IngramSwift/Buck-Controler-based-on-STM32/样品.jpg

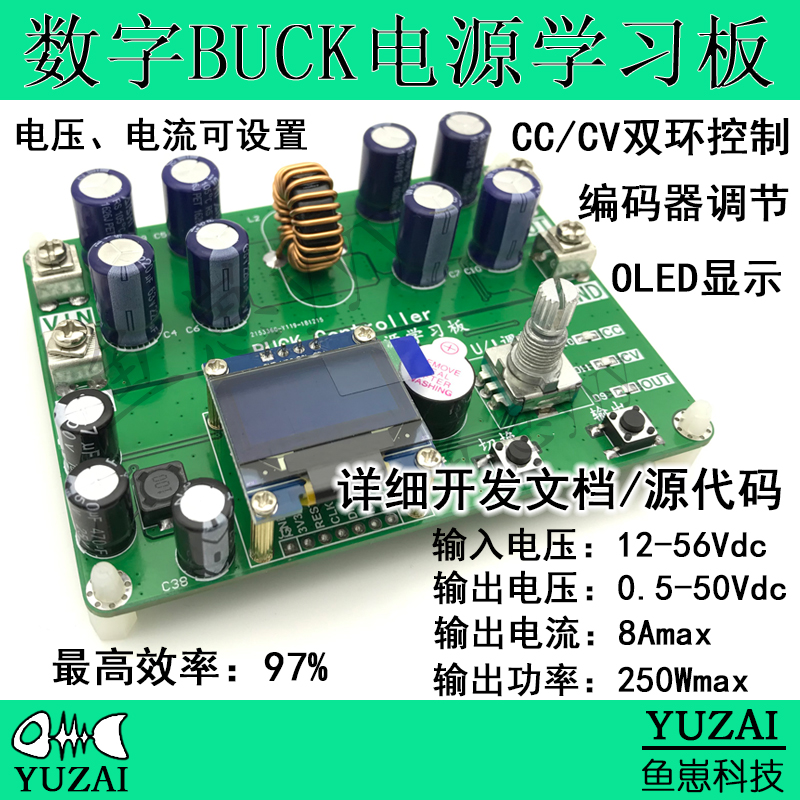
样品.jpg
