IngramSwift/Buck-Controler-based-on-STM32/同步整流BUCK资料_V1.2/程序代码/Buck_M0+_V1.1_VSCode/校准说明.JPG

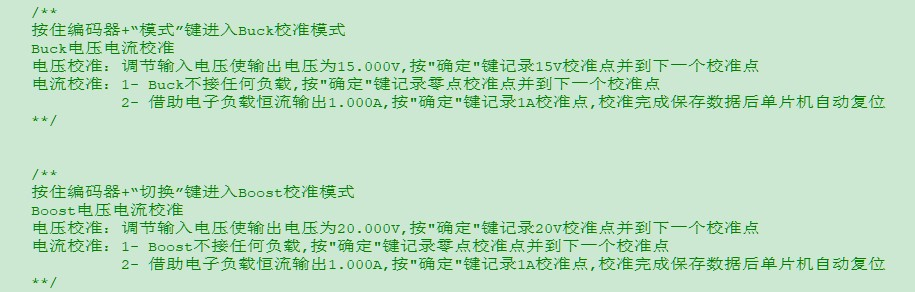
同步整流BUCK资料_V1.2/程序代码/Buck_M0+_V1.1_VSCode/校准说明.JPG
