IngramSwift/Buck-Controler-based-on-STM32/同步整流BUCK资料_V1.2/程序代码/Buck_M0+_V1.1/说明.txt

====================================================
181108-
	1）加入电压电流校准 （已完成）
====================================================
