IngramSwift/Buck-Controler-based-on-STM32/2_电路原理图/数字电源控制器_元件清单.xlsx

序号 | 名称 | 位号 | 规格 | 数量 | 引脚
1 | LED | LED1,LED2,LED3 | 0805 | 3 | 2
2 | 33pf | C5,C6 | 0805 | 2 | 2
3 | 104 | C1,C2,C3,C4,C7,C8,C9,C10,C11,C12,C13,C14,C19,C21,C22,C23,C24 | 0805 | 17 | 2
4 | 103 | C18,C20 | 0805 | 2 | 2
5 | 100R | R4 ,R21,R22 | 0805 | 3 | 2
6 | 103 | R1,R6,R2,R3,R5 | 0805 | 5 | 2
7 | 102 | R12,R13,R16,R18,R19 | 0805 | 5 | 2
8 | 512 | R8,R15 | 0805 | 2 | 2
9 | 303 | R9 | 0805 | 1 | 2
10 | 472 | R10 | 0805 | 1 | 2
11 | 913 | R11,R14 | 0805 | 2 | 2
12 | 363 | R17 | 0805 | 1 | 2
13 | 采样电阻r010_5W | R20 |  | 1 | 2
14 | 电解电容_100uF/63v | C15 |  | 1 | 2 | 3.5元/20个
15 | 电解电容_470uF/35v | C16,C17 |  | 2 | 2 | 4.8元/20个
16 | 电解电容_220uF/63v | C25,C26,C27,C28,C29,C30,C31,C32 |  | 8 | 2 | 2.9元/10个
17 | 电感_33uH | U8 |  | 1 | 2 | 优信电子(2.3元/个)
18 | 电感_100uH | U6 |  | 1 | 2 | 优信电子(0.37元/个)
19 | ss310 | D1,D2 |  | 2 | 2 | 优信电子(2元/5个)
20 | 4148_二极管 | D3,D4 |  | 2 | 2 |  |  | 3元/50个
21 | BELL(1.0)CM | U3 |  | 1 | 2 | 0.49元/个
22 | 晶振_8MHz | X1 |  | 1 | 2 | 优信电子(2.8元/10个)
23 | 三极管_SS8050 | U2 |  | 1 | 3 | 优信电子(1.4元/20个)
24 | MOSFET_HY1908D | Q1,Q2 |  | 2 | 3 |  | 1.3元/个
25 | 0.96OLED_4P | OLED1 |  | 1 | 4 | 优信电子(13元/个)
26 | EC11E15 | SW3 |  | 1 | 7 | 优信电子(1.5元/个)
27 | XL7005ADJ | U4 |  | 1 | 9 | 优信电子(0.91元/个)
28 | AMS1117-3.3V | U5 |  | 1 | 4 | 优信电子(0.4元/个)
29 | EG3013 | U7 |  | 1 | 8 |  | 0.52元/个
30 | LMC6482AIM | U9 |  | 1 | 8 | 优信电子(4.85元/块)
31 | STM32F030K6T6 | U1 |  | 1 | 32 | 优信电子(2.9元/块)
