IngramSwift/Buck-Controler-based-on-STM32/2_电路原理图/元件清单.xlsx

序号 | 型号 | 位号 | 封装 | 数量 | 引脚
电容
1 | 33pf | C5,C6 | 0805 | 20 | 2
2 | 104 | C1,C2,C3,C4,C7,C8,C9,C10,C11,C12,C13,C14,C19,C21,C22,C23,C24 | 0805 | 30 | 2
3 | 103 | C18,C20 | 0805 | 20 | 2
电阻
4 | 101 | R4,R21,R22 | 0805 | 20 | 2
5 | 102 | R12,R13,R16,R18,R19 | 0805 | 20 | 2
6 | 103 | R1,R6,R2,R3,R5 | 0805 | 20 | 2
7 | 512 | R8,R15 | 0805 | 20 | 2
8 | 303 | R9 | 0805 | 20 | 2
9 | 472 | R10 | 0805 | 20 | 2
10 | 913 | R11,R14 | 0805 | 20 | 2
11 | 363 | R17 | 0805 | 20 | 2
