IngramSwift/Buck-Controler-based-on-STM32/2_电路原理图/同步整流BUCK-SCH.pdf

# BUCK主拓扑

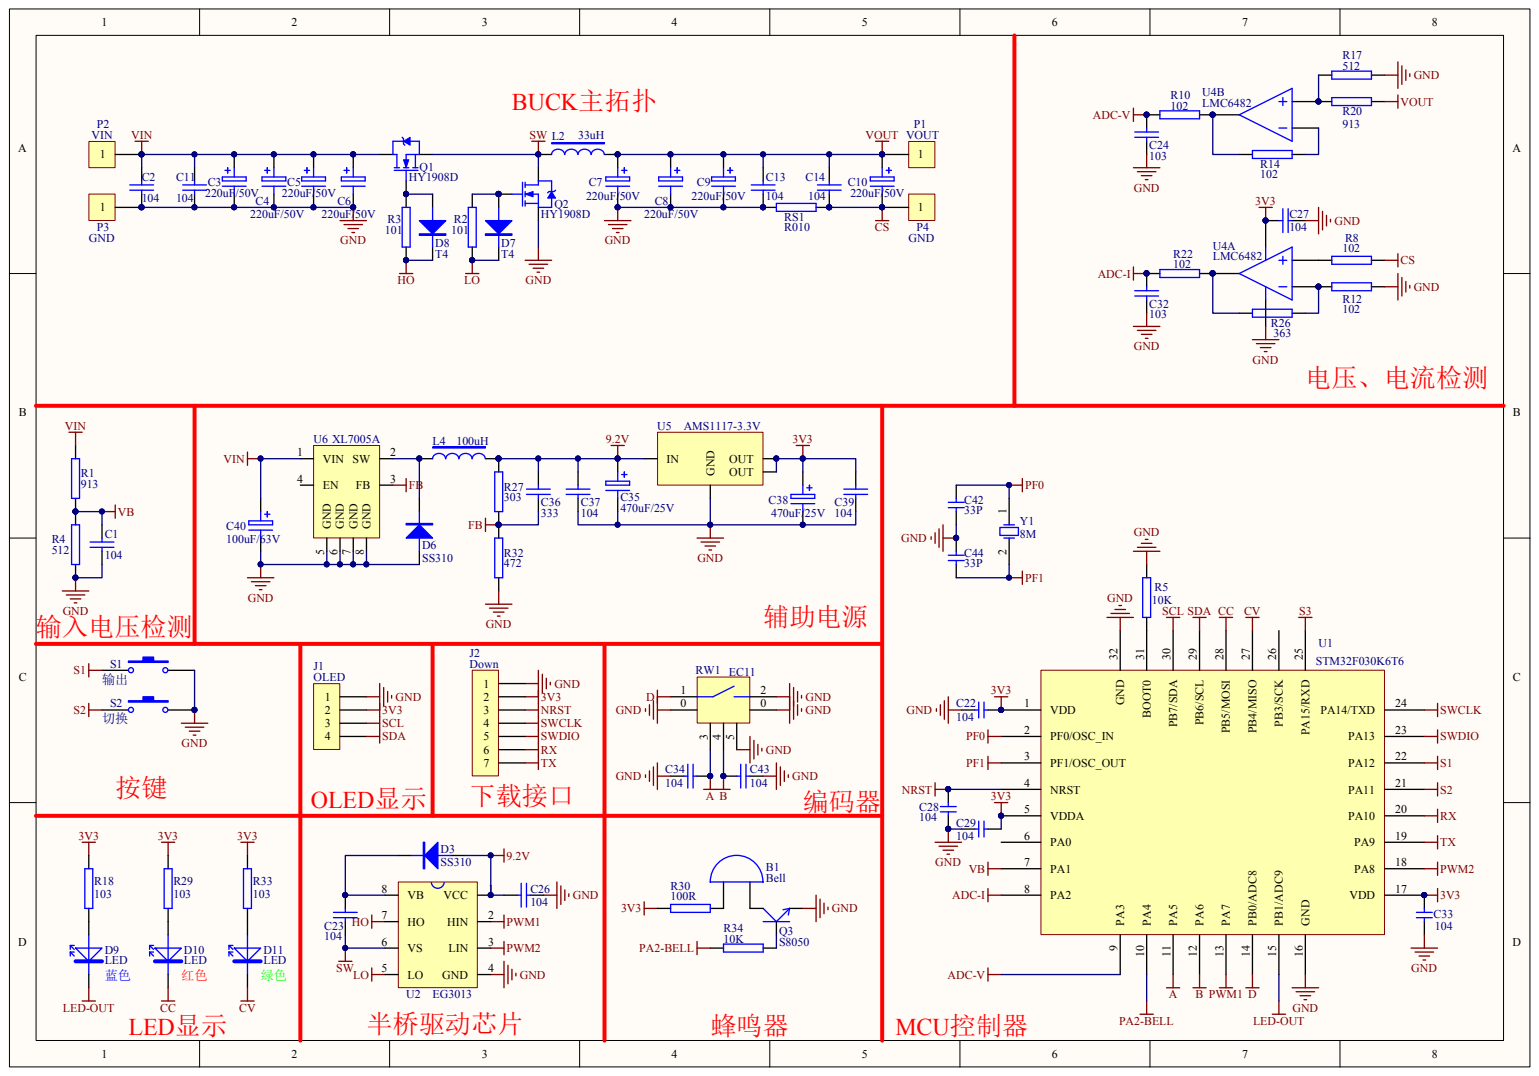
[picture p13: page 1]
