IngramSwift/Buck-Controler-based-on-STM32/同步整流BUCK资料_V1.2/参考资料/Buck变换器的闭环回路设计之PID调节教程.pdf

# Buck 变换器的闭环回路设计之 PID 调节

## 1.确定电容电感大小

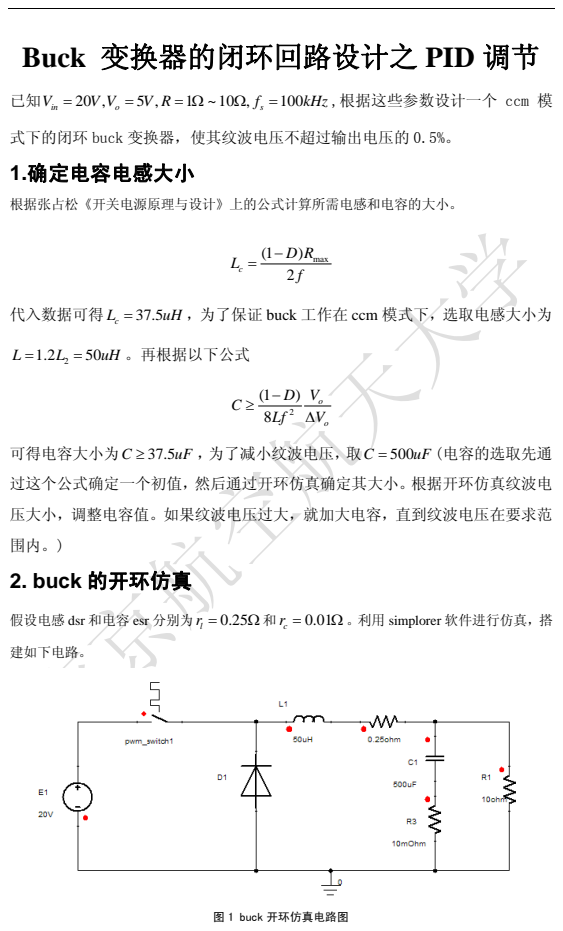
[picture p14: page 1]
kHz in; ,根据这些参数设计一个 ccm 模; max (1; 代入数据可得; ，为了保证 buck 工作在 ccm 模式下，选取电感大小为; 。再根据以下公式; 可得电容大小为C; ，为了减小纹波电压，取C; (电容的选取先通; 围内。) 2. buck 的开环仿真; 假设电感 dsr 和电容 esr 分别为; W 。利用 simplorer 软件进行仿真，搭; 建如下电路。; 图 1 buck 开环仿真电路图

式下的闭环 buck 变换器，使其纹波电压不超过输出电压的 0.5%。

根据张占松《开关电源原理与设计》上的公式计算所需电感和电容的大小。

过这个公式确定一个初值，然后通过开环仿真确定其大小。根据开环仿真纹波电

压大小，调整电容值。如果纹波电压过大，就加大电容，直到纹波电压在要求范

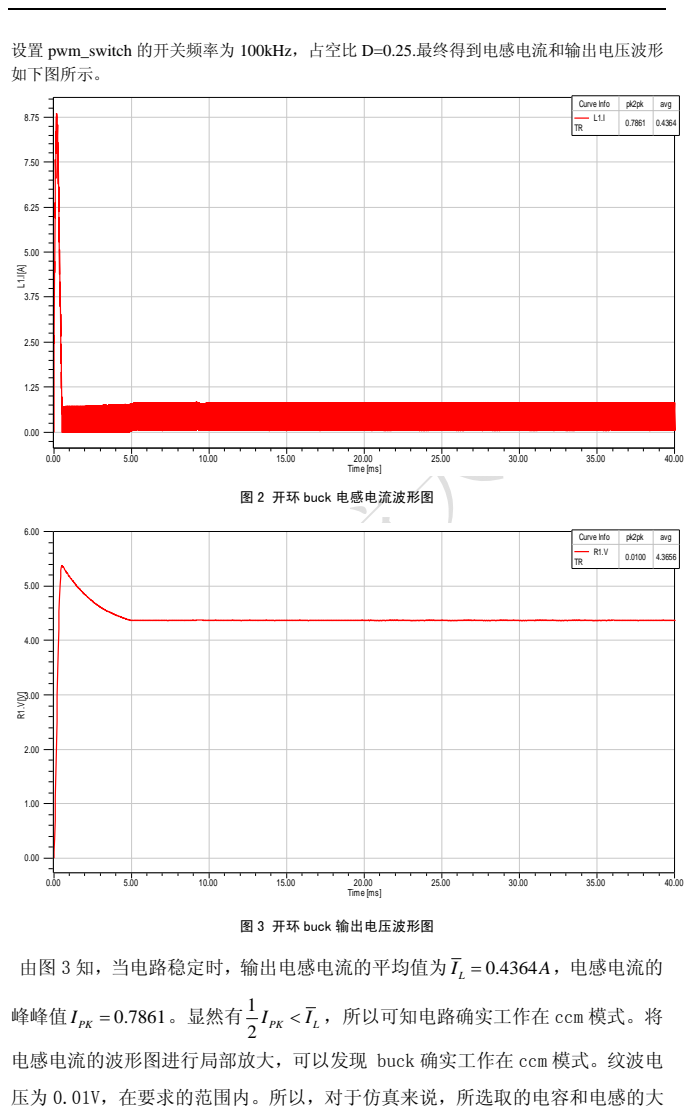
[picture p15: page 2]
Time [ms]; 40.00 Time [ms]; 由图 3 知，当电路稳定时，输出电感电流的平均值为; ，电感电流的; 峰峰值; 。显然有 1; I < ，所以可知电路确实工作在 ccm 模式。将

设置 pwm_switch 的开关频率为 100kHz，占空比 D=0.25.最终得到电感电流和输出电压波形
如下图所示。

Curve Info | | pk2pk | avg
TR | L1.I | 0.7861 | 0.4364

图 2 开环 buck 电感电流波形图

TR | R1.V | 0.0100 | 4.3656

图 3 开环 buck 输出电压波形图

电感电流的波形图进行局部放大，可以发现 buck 确实工作在 ccm 模式。纹波电

压为 0.01V，在要求的范围内。所以，对于仿真来说，所选取的电容和电感的大

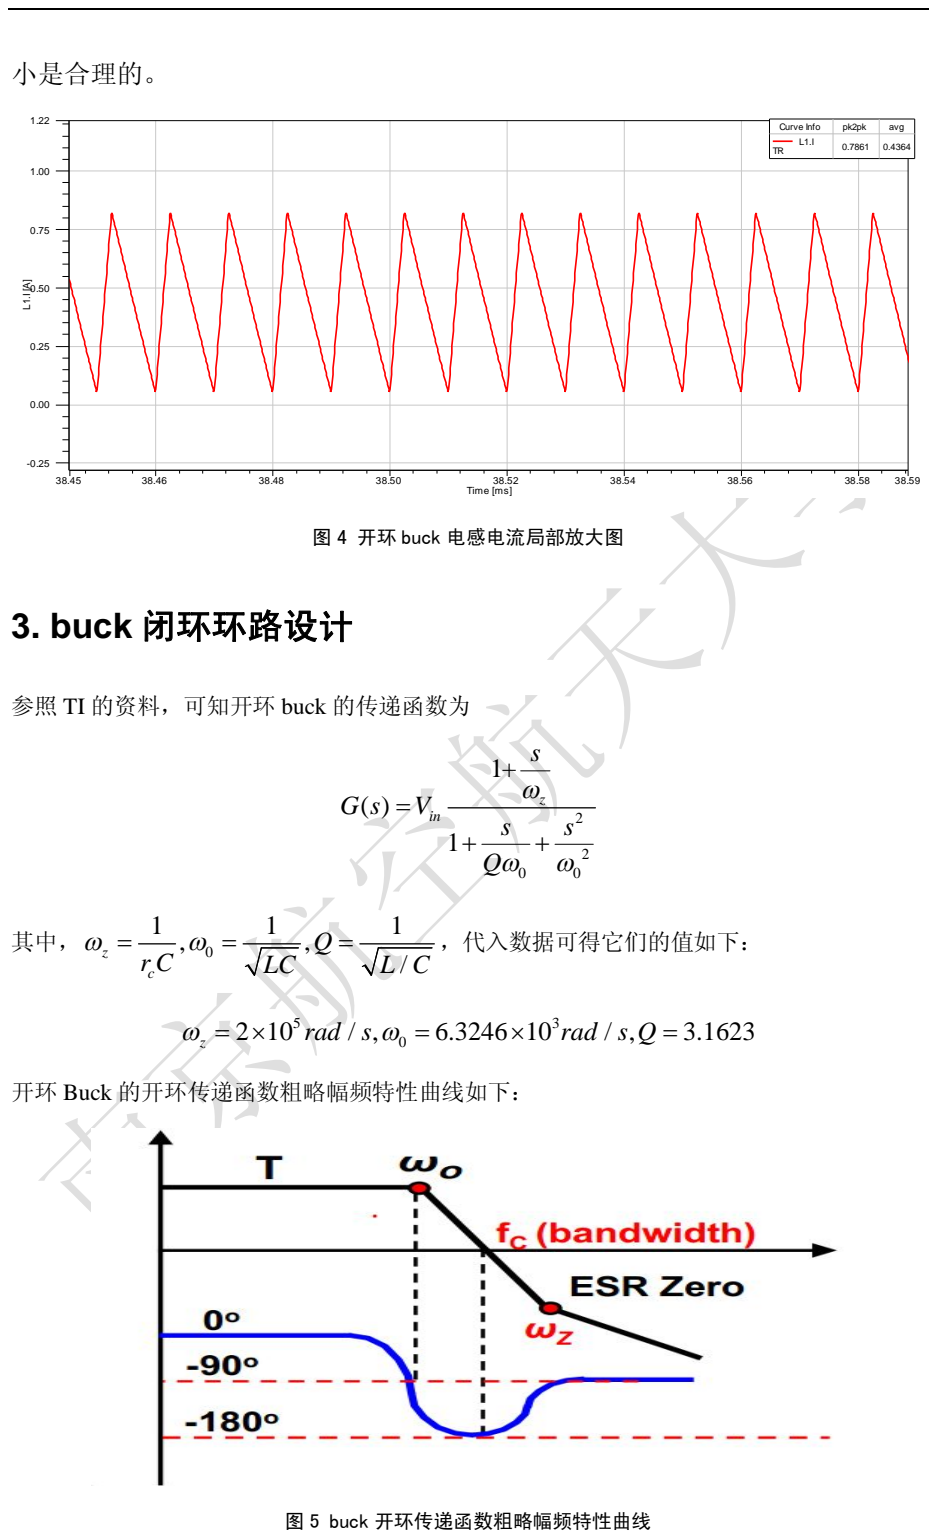
[picture p16: page 3]
小是合理的。; Time [ms]; 3. buck 闭环环路设计; ，代入数据可得它们的值如下：; = rad s; rad s Q; 图 5 buck 开环传递函数粗略幅频特性曲线

Curve Info | pk2pk | avg
L1.I TR | 0.7861 | 0.4364

图 4 开环 buck 电感电流局部放大图

参照 TI 的资料，可知开环 buck 的传递函数为

开环 Buck 的开环传递函数粗略幅频特性曲线如下：

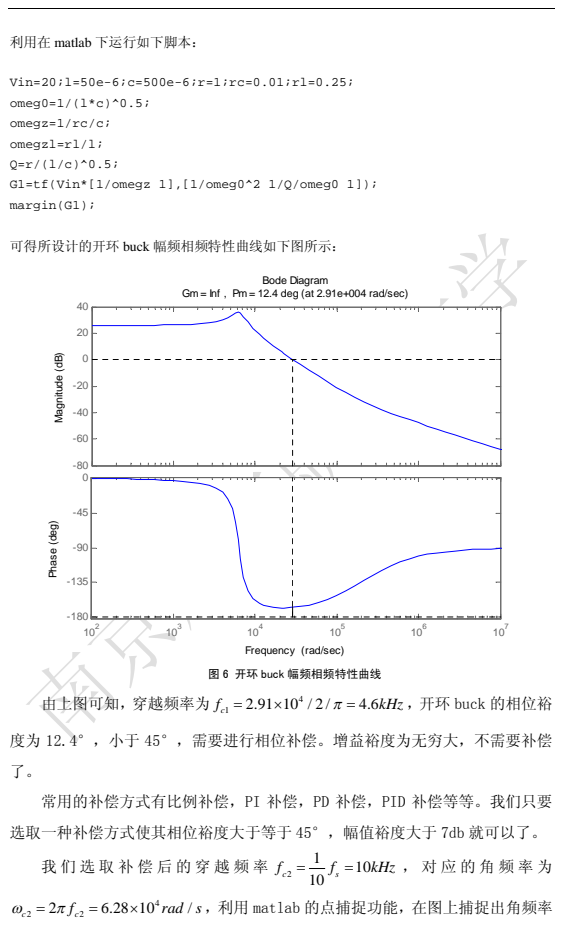
[picture p17: page 4]
Magnitude (dB); Phase (deg); Bode Diagram; 由上图可知，穿越频率为; kHz =; ，开环 buck 的相位裕; rad s ，利用 matlab 的点捕捉功能，在图上捕捉出角频率

利用在 matlab 下运行如下脚本：

Vin=20;l=50e-6;c=500e-6;r=1;rc=0.01;rl=0.25;
omeg0=1/(l*c)^0.5;
omegz=1/rc/c;
omegzl=rl/l;
G1=tf(Vin*[1/omegz 1],[1/omeg0^2 1/Q/omeg0 1]);
margin(G1);

可得所设计的开环 buck 幅频相频特性曲线如下图所示：

Gm = Inf , Pm = 12.4 deg (at 2.91e+004 rad/sec)

Frequency (rad/sec)

图 6 开环 buck 幅频相频特性曲线

度为 12.4°，小于 45°，需要进行相位补偿。增益裕度为无穷大，不需要补偿

常用的补偿方式有比例补偿，PI 补偿，PD 补偿，PID 补偿等等。我们只要

选取一种补偿方式使其相位裕度大于等于 45°，幅值裕度大于 7db 就可以了。

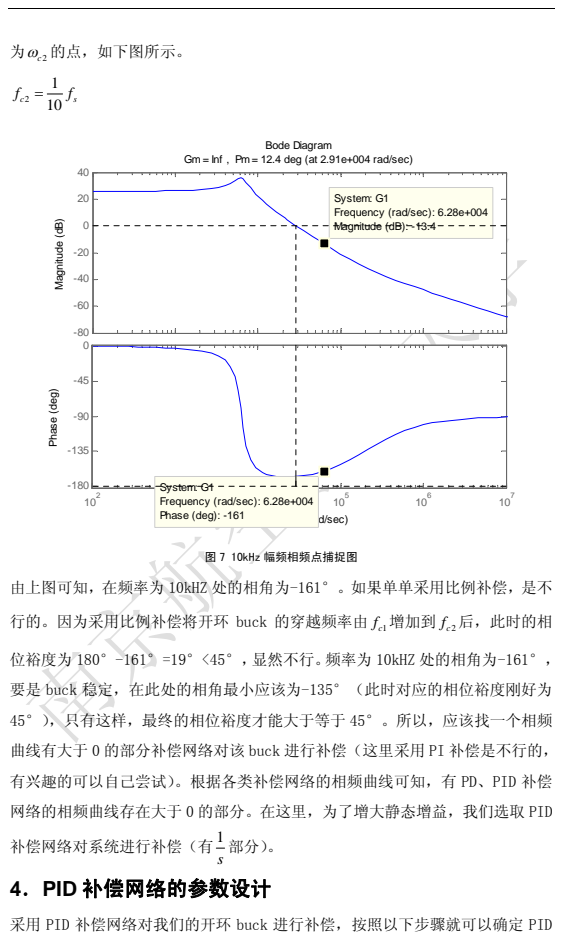
[picture p18: page 5]
为wc2 的点，如下图所示。; Bode Diagram; Phase (deg); Magnitude (dB); 图 7 10kHz 幅频相频点捕捉图; 4．PID 补偿网络的参数设计

Gm = Inf , Pm = 12.4 deg (at 2.91e+004 rad/sec)

System: G1
Frequency (rad/sec): 6.28e+004
Magnitude (dB): -13.4

Phase (deg): -161

Frequency (rad/sec)

由上图可知，在频率为 10kHZ 处的相角为-161°。如果单单采用比例补偿，是不

行的。因为采用比例补偿将开环 buck 的穿越频率由 c1 f 增加到 c2 f 后，此时的相

位裕度为 180°-161°=19°<45°，显然不行。频率为 10kHZ 处的相角为-161°，

要是 buck 稳定，在此处的相角最小应该为-135°（此时对应的相位裕度刚好为

45°），只有这样，最终的相位裕度才能大于等于 45°。所以，应该找一个相频

曲线有大于 0 的部分补偿网络对该 buck 进行补偿（这里采用 PI 补偿是不行的，

有兴趣的可以自己尝试）。根据各类补偿网络的相频曲线可知，有 PD、PID 补偿

网络的相频曲线存在大于 0 的部分。在这里，为了增大静态增益，我们选取 PID
补偿网络对系统进行补偿（有 1

采用 PID 补偿网络对我们的开环 buck 进行补偿，按照以下步骤就可以确定 PID

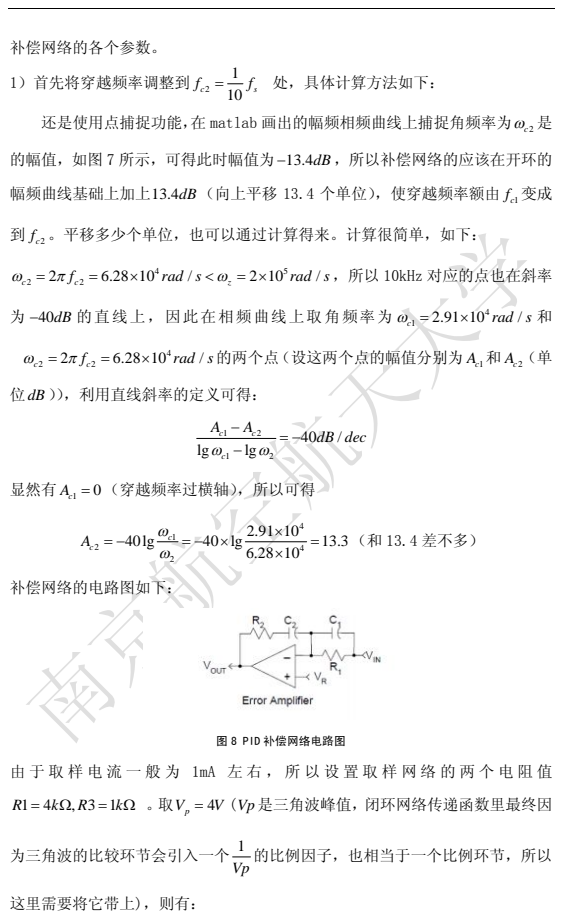
[picture p19: page 6]
补偿网络的各个参数。; 1）首先将穿越频率调整到 2; 处，具体计算方法如下：; 还是使用点捕捉功能，在 matlab 画出的幅频相频曲线上捕捉角频率为wc2 是; rad s; rad s，所以 10kHz 对应的点也在斜率; 为 -40dB 的直线上，因此在相频曲线上取角频率为; rad s 和; rad s 的两个点（设这两个点的幅值分别为 Ac1和 Ac2; 位dB）），利用直线斜率的定义可得：; dB dec; 显然有 1; 0 Ac = （穿越频率过横轴），所以可得; （和 13.4 差不多）; 补偿网络的电路图如下：; 图 8 PID 补偿网络电路图; (Vp是三角波峰值，闭环网络传递函数里最终因; 为三角波的比较环节会引入一个 1; 这里需要将它带上)，则有：

的幅值，如图 7 所示，可得此时幅值为-13.4dB ，所以补偿网络的应该在开环的

幅频曲线基础上加上13.4dB（向上平移 13.4 个单位），使穿越频率额由 c1 f 变成

到 c2 f 。平移多少个单位，也可以通过计算得来。计算很简单，如下：

的比例因子，也相当于一个比例环节，所以

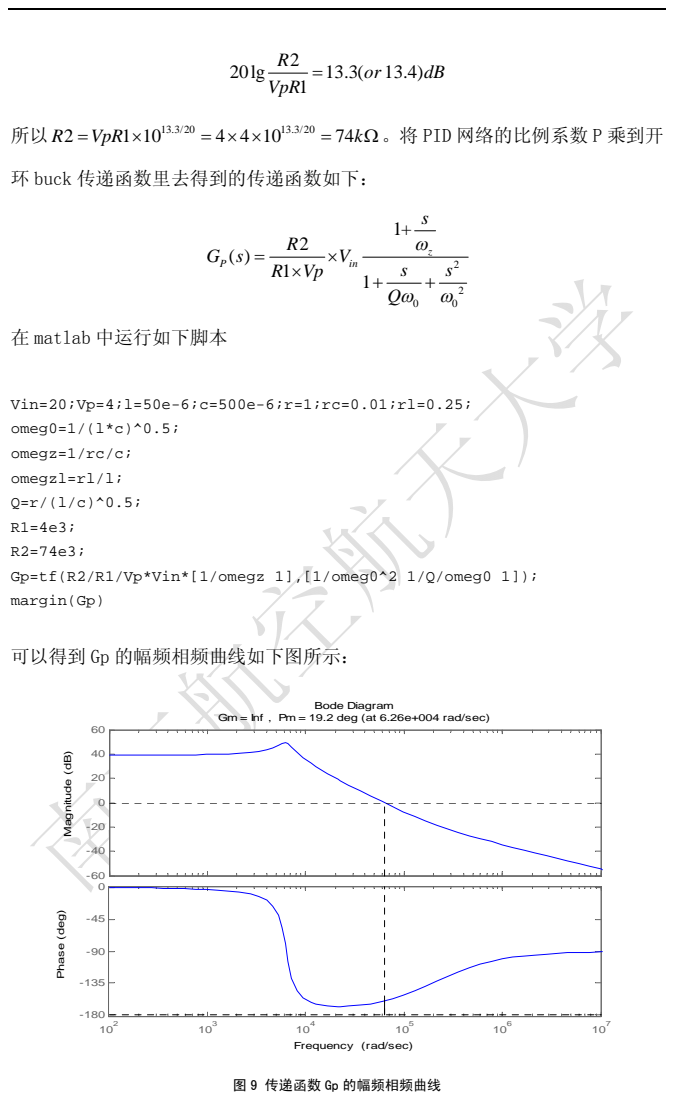
[picture p20: page 7]
VpR =; VpR; W。将 PID 网络的比例系数 P 乘到开; 环 buck 传递函数里去得到的传递函数如下：; 在 matlab 中运行如下脚本; Magnitude (dB); Phase (deg); Bode Diagram

Vin=20;Vp=4;l=50e-6;c=500e-6;r=1;rc=0.01;rl=0.25;
omeg0=1/(l*c)^0.5;
omegz=1/rc/c;
omegzl=rl/l;
Gp=tf(R2/R1/Vp*Vin*[1/omegz 1],[1/omeg0^2 1/Q/omeg0 1]);
margin(Gp)

可以得到 Gp 的幅频相频曲线如下图所示：

Gm = Inf , Pm = 19.2 deg (at 6.26e+004 rad/sec)

Frequency (rad/sec)

图 9 传递函数 Gp 的幅频相频曲线

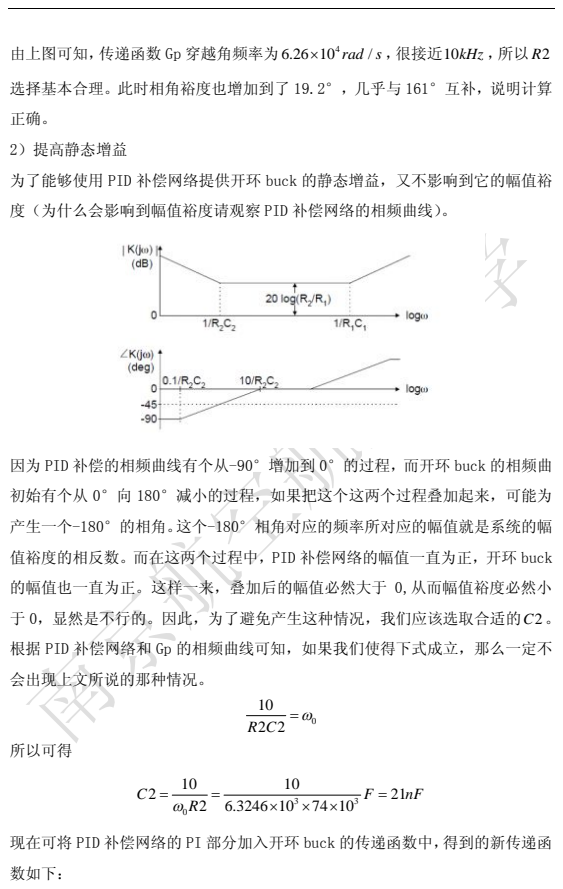
[picture p21: page 8]
由上图可知，传递函数 Gp 穿越角频率为; rad s ，很接近10kHz ，所以 R2; 2）提高静态增益; 会出现上文所说的那种情况。; 所以可得; 数如下：

选择基本合理。此时相角裕度也增加到了 19.2°，几乎与 161°互补，说明计算

为了能够使用 PID 补偿网络提供开环 buck 的静态增益，又不影响到它的幅值裕

度（为什么会影响到幅值裕度请观察 PID 补偿网络的相频曲线）。

因为 PID 补偿的相频曲线有个从-90°增加到 0°的过程，而开环 buck 的相频曲

初始有个从 0°向 180°减小的过程，如果把这个这两个过程叠加起来，可能为

产生一个-180°的相角。这个-180°相角对应的频率所对应的幅值就是系统的幅

值裕度的相反数。而在这两个过程中，PID 补偿网络的幅值一直为正，开环 buck

的幅值也一直为正。这样一来，叠加后的幅值必然大于 0,从而幅值裕度必然小

于 0，显然是不行的。因此，为了避免产生这种情况，我们应该选取合适的C2。

根据 PID 补偿网络和 Gp 的相频曲线可知，如果我们使得下式成立，那么一定不

现在可将 PID 补偿网络的 PI 部分加入开环 buck 的传递函数中，得到的新传递函

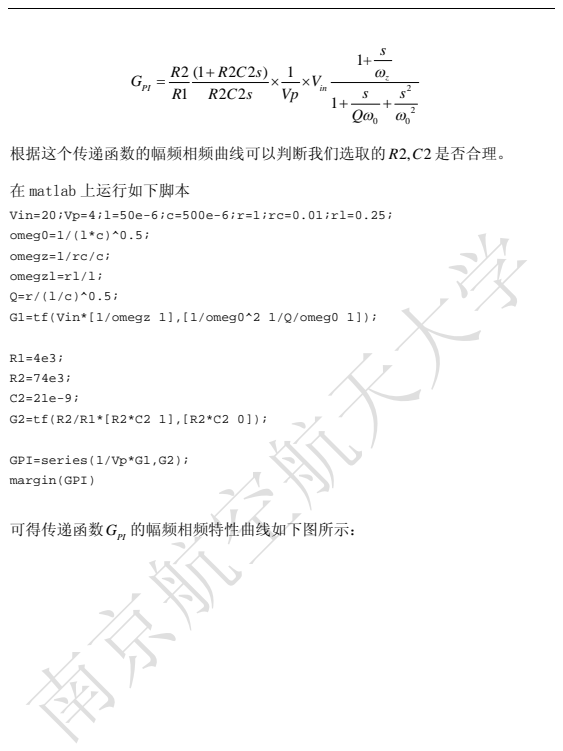
[picture p22: page 9]
根据这个传递函数的幅频相频曲线可以判断我们选取的 R C2, 2 是否合理。; 可得传递函数GPI 的幅频相频特性曲线如下图所示：

在 matlab 上运行如下脚本
Vin=20;Vp=4;l=50e-6;c=500e-6;r=1;rc=0.01;rl=0.25;
omeg0=1/(l*c)^0.5;
omegz=1/rc/c;
omegzl=rl/l;
G1=tf(Vin*[1/omegz 1],[1/omeg0^2 1/Q/omeg0 1]);

GPI=series(1/Vp*G1,G2);
margin(GPI)

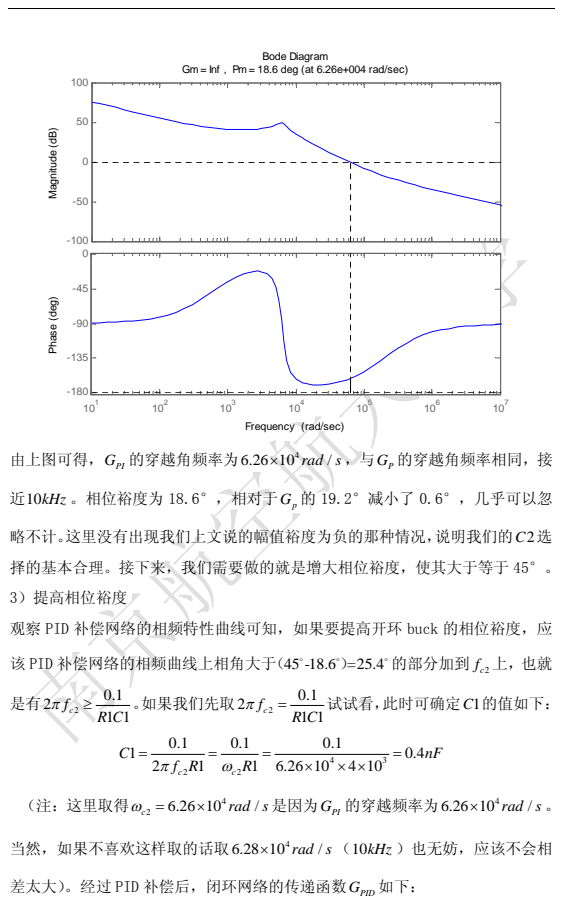
[picture p23: page 10]
Magnitude (dB); Phase (deg); Bode Diagram; 由上图可得，GPI 的穿越角频率为; rad s ，与GP 的穿越角频率相同，接; 略不计。这里没有出现我们上文说的幅值裕度为负的那种情况，说明我们的C2选; 3）提高相位裕度; 该 PID 补偿网络的相频曲线上相角大于 45 -18.6 =25.4 （ o; 的部分加到 c2 f 上，也就; 。如果我们先取; 试试看，此时可确定C1的值如下：; （注：这里取得; ´ rad s 是因为GPI 的穿越频率为; rad s 。; 当然，如果不喜欢这样取的话取; rad s （10kHz ）也无妨，应该不会相

Gm = Inf , Pm = 18.6 deg (at 6.26e+004 rad/sec)

Frequency (rad/sec)

近10kHz 。相位裕度为 18.6°，相对于Gp 的 19.2°减小了 0.6°，几乎可以忽

择的基本合理。接下来，我们需要做的就是增大相位裕度，使其大于等于 45°。

观察 PID 补偿网络的相频特性曲线可知，如果要提高开环 buck 的相位裕度，应

差太大）。经过 PID 补偿后，闭环网络的传递函数GPID 如下：

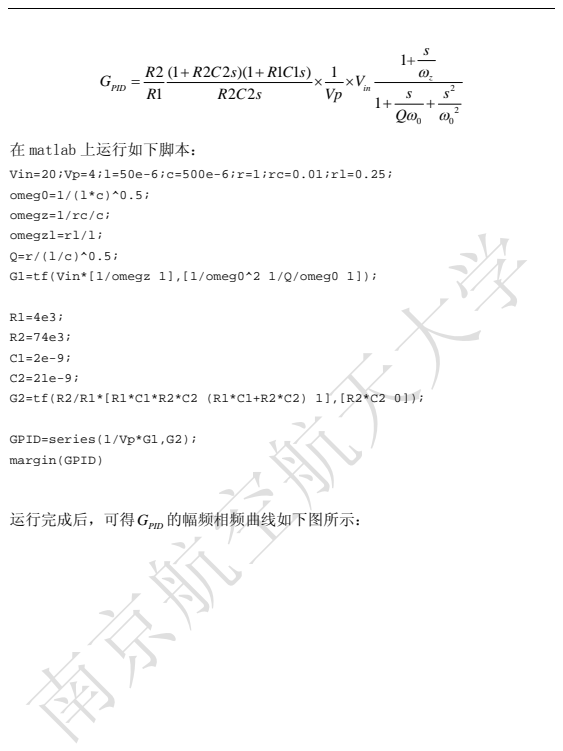
[picture p24: page 11]
PID

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

GPID=series(1/Vp*G1,G2);
margin(GPID)

运行完成后，可得GPID 的幅频相频曲线如下图所示：

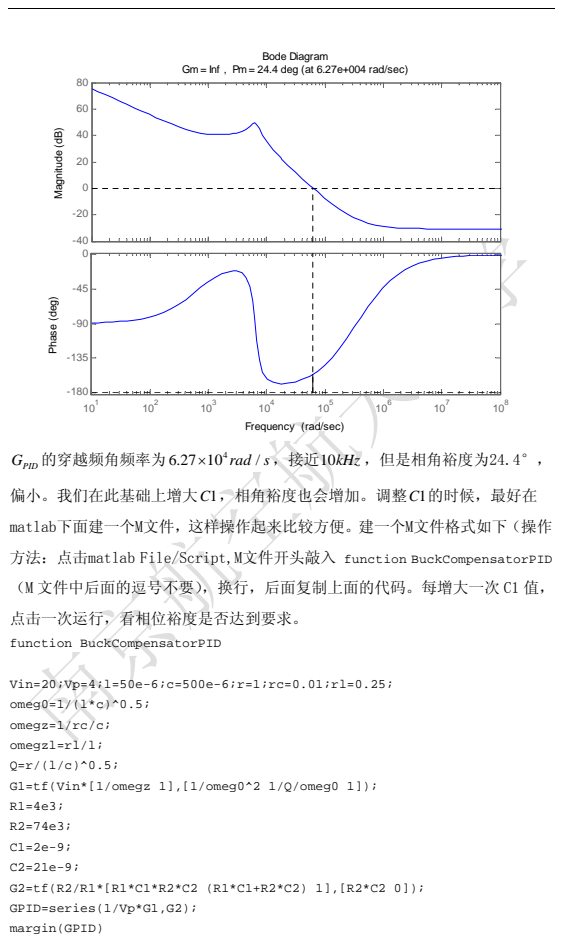
[picture p25: page 12]
Magnitude (dB); Phase (deg); Bode Diagram; GPID 的穿越频角频率为; / ´ rad s ，接近10kHz ，但是相角裕度为24.4°，; 点击一次运行，看相位裕度是否达到要求。; function BuckCompensatorPID; Vin=20;Vp=4;l=50e-6;c=500e-6;r=1;rc=0.01;rl=0.25; omeg0=1/(l*c)^0.5; omegz=1/rc/c; omegzl=rl/l; Q=r/(l/c)^0.5; G1=tf(Vin*[1/omegz 1],[1/omeg0^2 1/Q/omeg0 1]); R1=4e3; R2=74e3; C1=2e-9; C2=21e-9; G2=tf(R2/R1*[R1*C1*R2*C2 (R1*C1+R2*C2) 1],[R2*C2 0]); GPID=series(1/Vp*G1,G2); margin(GPID)

Gm = Inf , Pm = 24.4 deg (at 6.27e+004 rad/sec)

Frequency (rad/sec)

偏小。我们在此基础上增大C1，相角裕度也会增加。调整C1的时候，最好在

matlab下面建一个M文件，这样操作起来比较方便。建一个M文件格式如下（操作

方法：点击matlab File/Script,M文件开头敲入 function BuckCompensatorPID

（M 文件中后面的逗号不要），换行，后面复制上面的代码。每增大一次 C1 值，

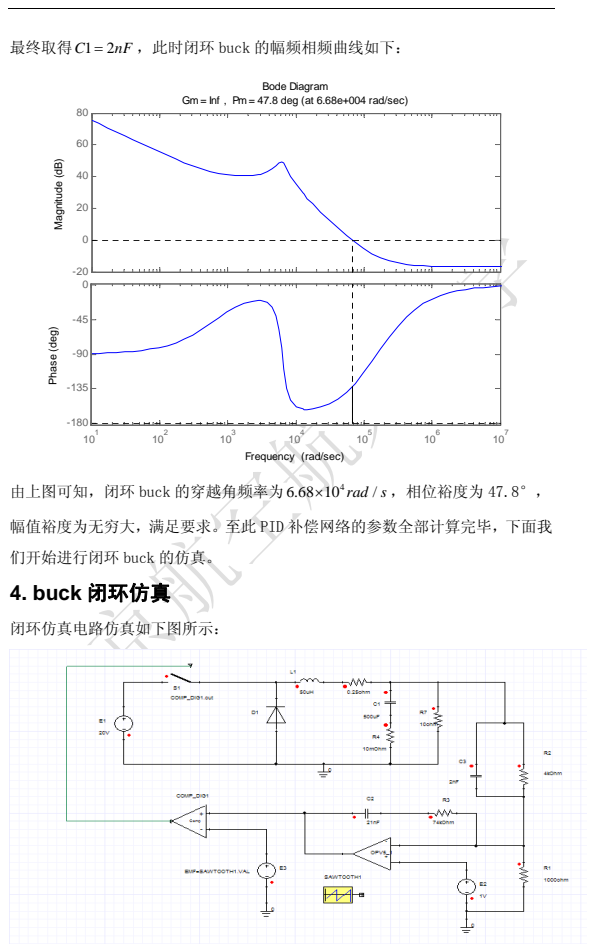
[picture p26: page 13]
最终取得C; ，此时闭环 buck 的幅频相频曲线如下：; Magnitude (dB); Phase (deg); Bode Diagram; 由上图可知，闭环 buck 的穿越角频率为; rad s ，相位裕度为 47.8°，; 闭环仿真电路仿真如下图所示：

Gm = Inf , Pm = 47.8 deg (at 6.68e+004 rad/sec)

Frequency (rad/sec)

幅值裕度为无穷大，满足要求。至此 PID 补偿网络的参数全部计算完毕，下面我

们开始进行闭环 buck 的仿真。
4. buck 闭环仿真

## 35.00 L1.I [A]

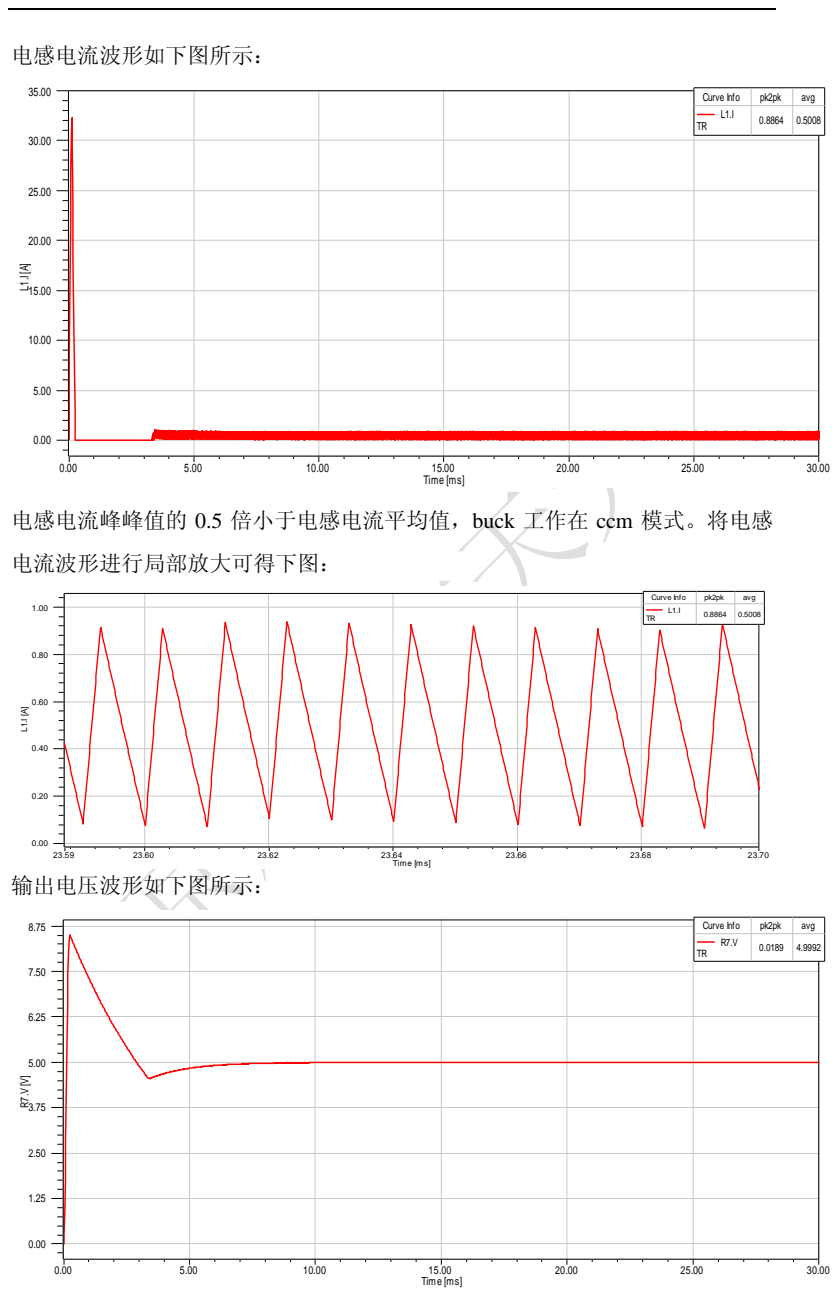
[picture p27: page 14]
电感电流波形如下图所示：; Time [ms]; 电流波形进行局部放大可得下图：; 23.70 Time [ms]; 输出电压波形如下图所示：; 30.00 Time [ms]

Curve Info | pk2pk | avg
L1.I TR | 0.8864 | 0.5008

电感电流峰峰值的 0.5 倍小于电感电流平均值，buck 工作在 ccm 模式。将电感

TR L1.I | 0.8864 | 0.5008

R7.V TR | 0.0189 | 4.9992

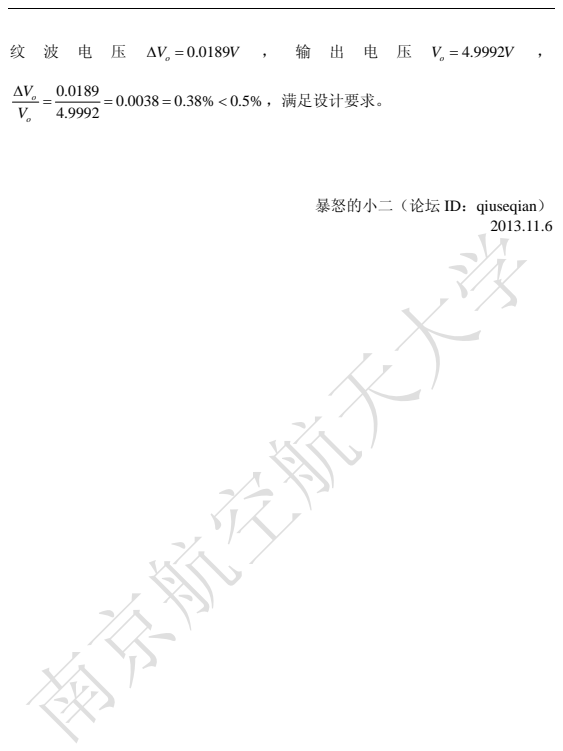
[picture p28: page 15]
，满足设计要求。

暴怒的小二（论坛 ID：qiuseqian）
