IngramSwift/Buck-Controler-based-on-STM32/同步整流BUCK资料_V1.2/程序代码/Buck_M0+_V1.1/BUCK-20181220.pdf

# BUCK主拓扑

# 电压、电流检测

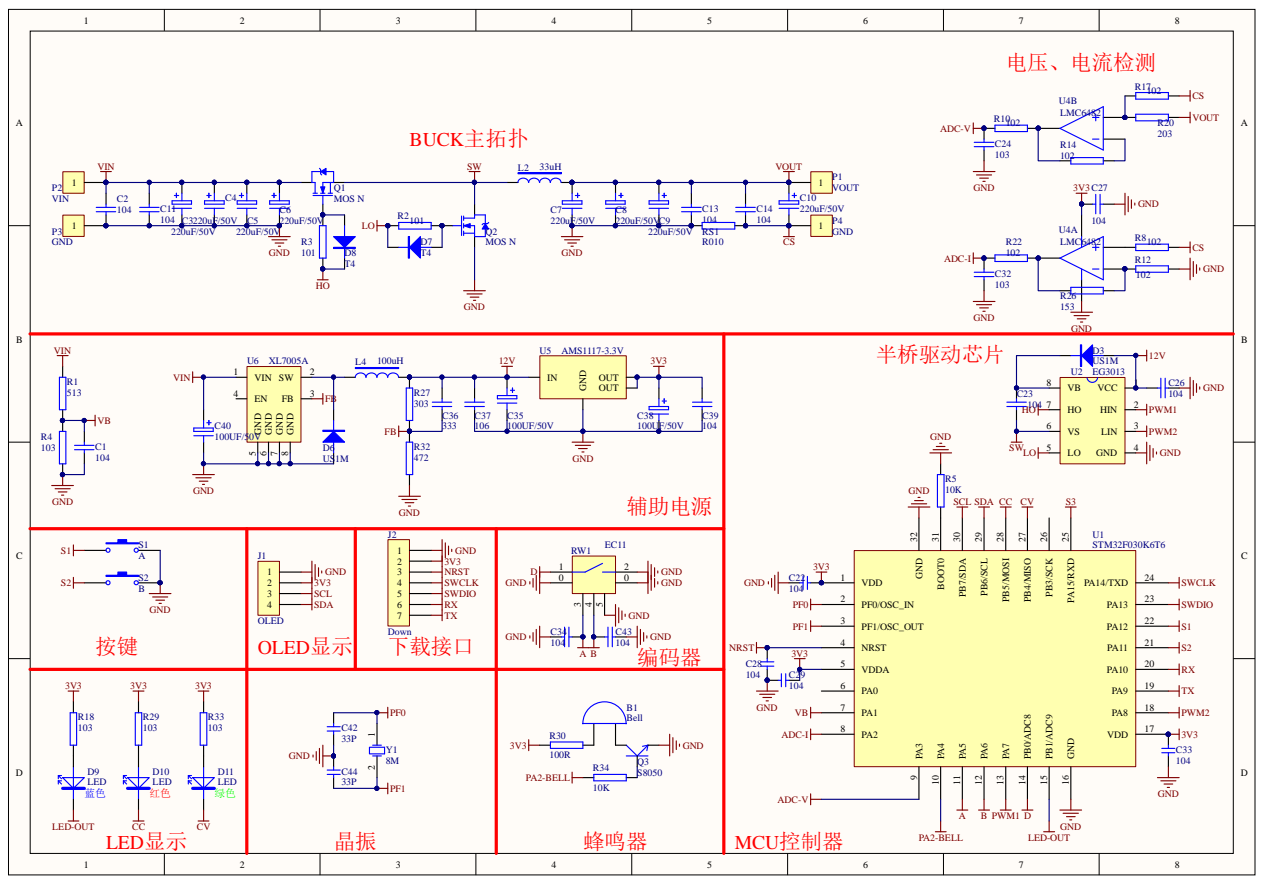
[picture p29: page 1]
