IngramSwift/Buck-Controler-based-on-STM32/2_电路原理图/原理图_数字电源控制器.pdf

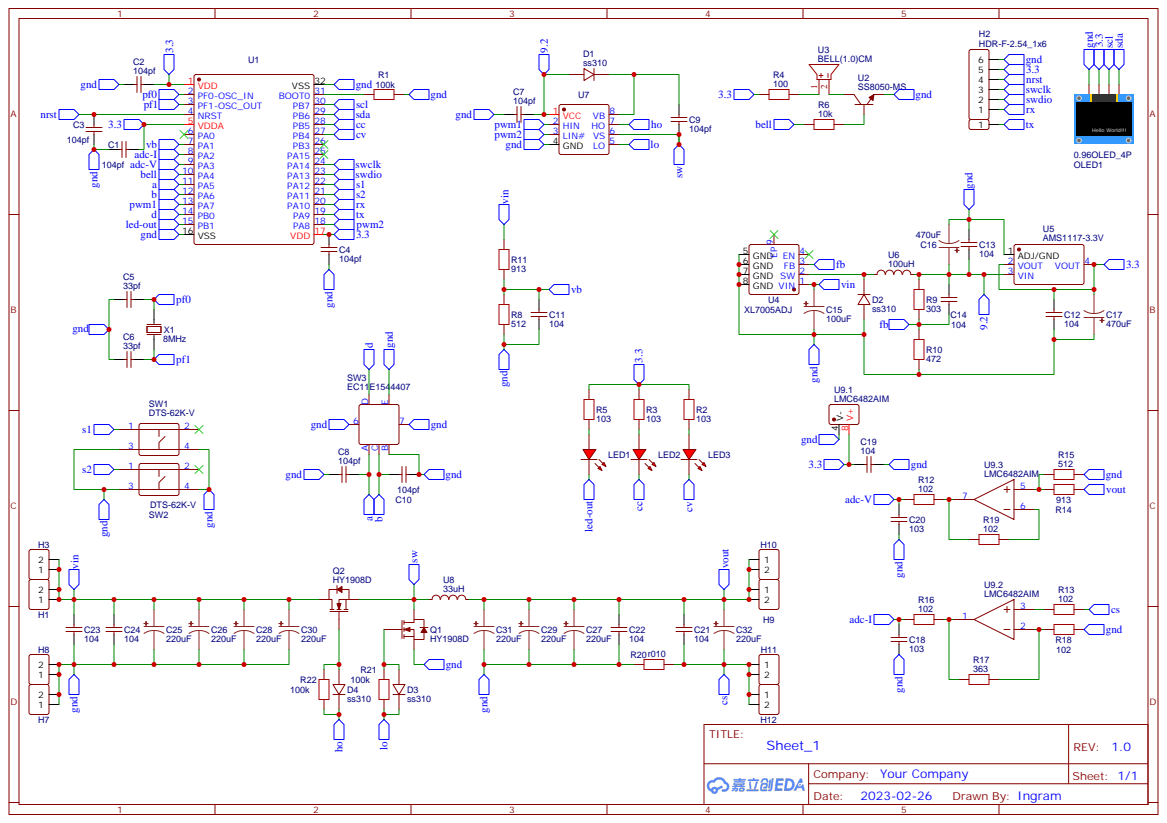
[picture p30: page 1]
