IngramSwift/Buck-Controler-based-on-STM32/同步整流BUCK资料_V1.2/电路图/同步整流BUCK-PCB.pdf

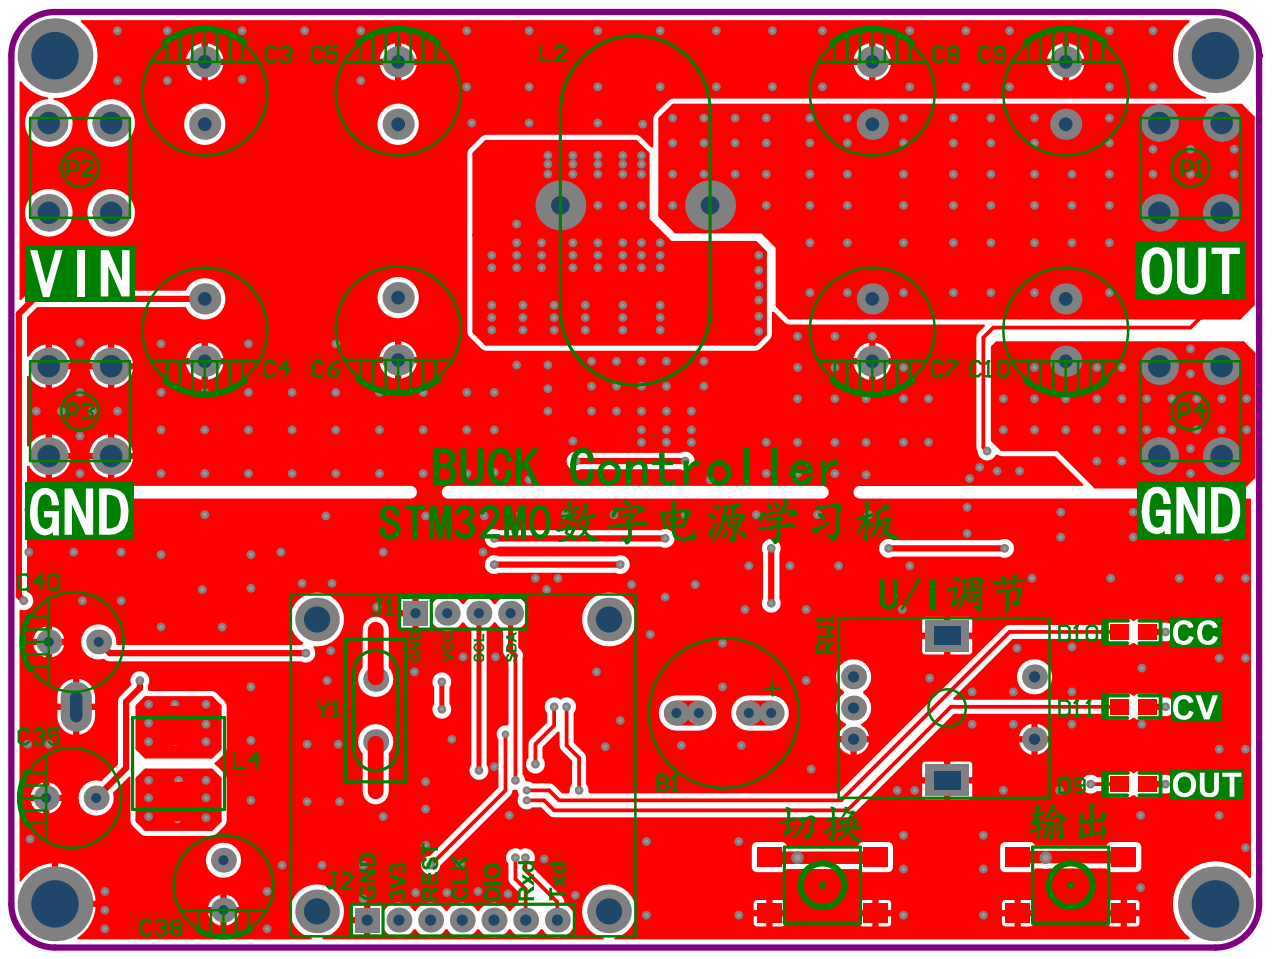
[picture p31: page 1]

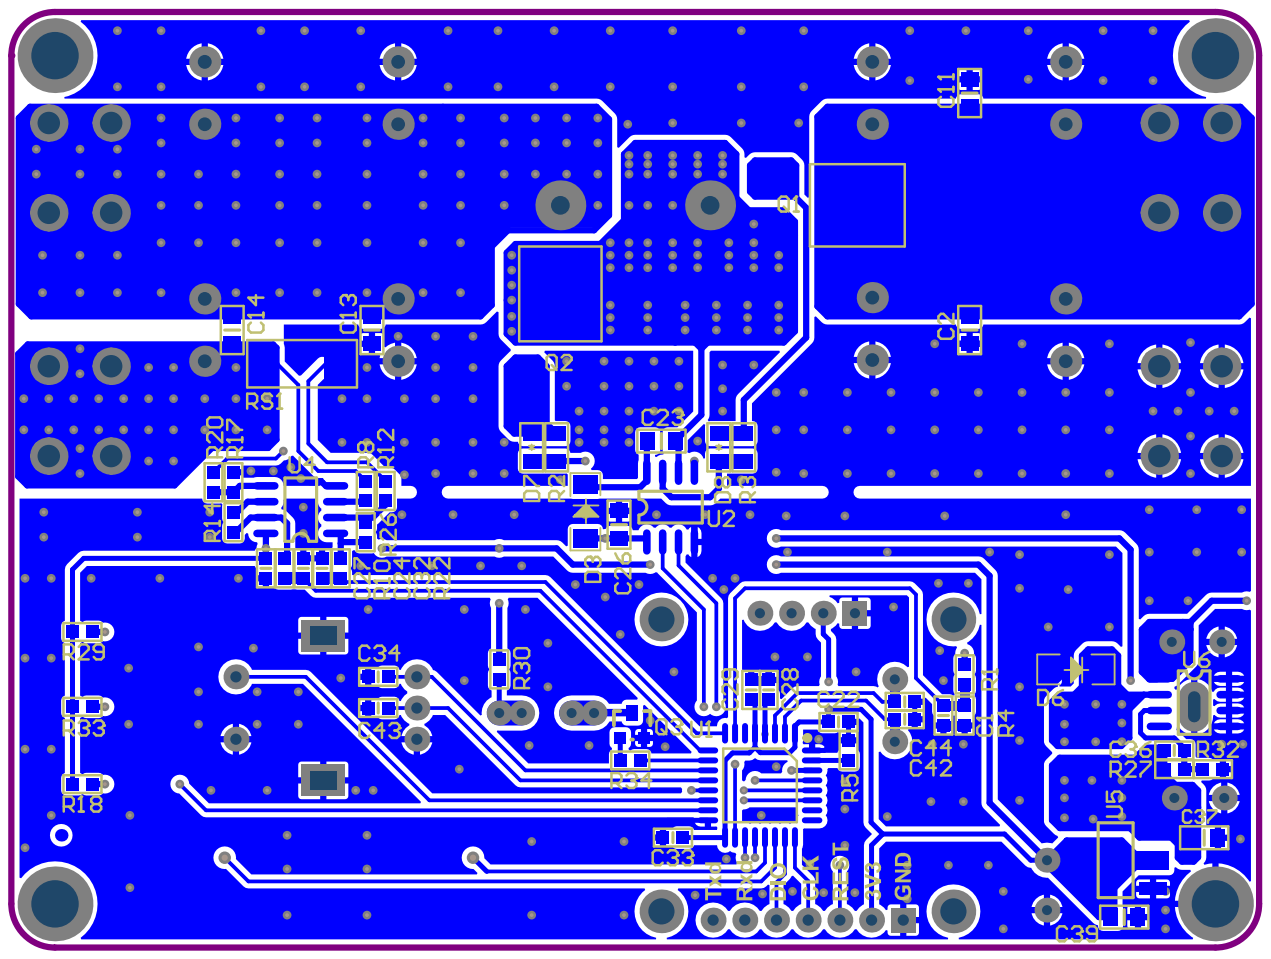
[picture p32: page 2]
