IngramSwift/Buck-Controler-based-on-STM32/同步整流BUCK资料_V1.2/程序代码/Buck_M0+_V1.1/Projects/user/main.c

/**
  ******************************************************************************
  * @file    ADC/ADC_BasicExample/main.c 
  * @author  MCD Application Team
  * @version V1.4.0
  * @date    24-July-2014
  * @brief   Main program body
  ******************************************************************************
  * @attention
  *
  * <h2><center>&copy; COPYRIGHT 2014 STMicroelectronics</center></h2>
  *
  * Licensed under MCD-ST Liberty SW License Agreement V2, (the "License");
  * You may not use this file except in compliance with the License.
  * You may obtain a copy of the License at:
  *
  *        http://www.st.com/software_license_agreement_liberty_v2
  *
  * Unless required by applicable law or agreed to in writing, software 
  * distributed under the License is distributed on an "AS IS" BASIS, 
  * WITHOUT WARRANTIES OR CONDITIONS OF ANY KIND, either express or implied.
  * See the License for the specific language governing permissions and
  * limitations under the License.
  *
  ******************************************************************************
  */

/* Includes ------------------------------------------------------------------*/
#include "stm32f0xx.h"                  // Device header
#include "led.h"
#include "adc.h"
#include "timer.h"
#include "pwm.h"
#include "delay.h"
#include "oled.h"
#include "key.h"

#include "control.h"
#include "calibration.h"

#include "freeRTOS_task.h"

/* Private typedef -----------------------------------------------------------*/
/* Private define ------------------------------------------------------------*/

/* Private macro -------------------------------------------------------------*/
/* Private variables ---------------------------------------------------------*/

/* Private function prototypes -----------------------------------------------*/
static void SetSystemCLK_Config(void);
#if USE_USART_PRINTF
static void USART_Config(void);
#endif
/* Private functions ---------------------------------------------------------*/

/**
  * @brief  Main program.
  * @param  None
  * @retval None
  */
int main(void)
{
	SetSystemCLK_Config();    /* Configure system clock */
	#if USE_USART_PRINTF
	USART_Config();
	#endif 
	PWM_Config();             /* Configure PWM */
	PID_Config();
	ADC_Config();             /* Configure ADC */
	LED_Config();			  /* Configure LED */
	OLED_Config();            /* Configure OLED */
	Key_Config();             /* Configure key and buzzer */
	TIM3_Config();
	Read_CalibKey();
	Read_CalibData();
	TIM14_Config();
	
	FreeRTOS_Task_Config();   /* Configure freeRTOS task */
	
	for(;;) { ; }

}


/**
  * @brief  GPIO configuration
  * @param  None
  * @retval None
  */
static void SetSystemCLK_Config(void)
{
	RCC_DeInit();
	RCC_HSICmd(ENABLE);
	while(RCC_GetFlagStatus(RCC_FLAG_HSIRDY) == RESET);
	
	RCC_HSEConfig(RCC_HSE_ON);
	while(RCC_GetFlagStatus(RCC_FLAG_HSERDY) == RESET);
	
	FLASH->ACR = FLASH_ACR_PRFTBE | FLASH_ACR_LATENCY;
	
	RCC_HCLKConfig(RCC_SYSCLK_Div1);
	RCC_PCLKConfig(RCC_HCLK_Div1);

	RCC_PLLConfig(RCC_PLLSource_HSE, RCC_PLLMul_6);
	RCC_PLLCmd(ENABLE);
	while(RCC_GetFlagStatus(RCC_FLAG_PLLRDY) == RESET);
	
	RCC_SYSCLKConfig(RCC_SYSCLKSource_PLLCLK);
	
	if(SysTick_Config(48000000u / 1000))
	{
		while(1) {;}
	}
	NVIC_SetPriority(SysTick_IRQn, 0);
	
}


#if USE_USART_PRINTF
/**
  * @brief Configure the USART Device
  * @param  None
  * @retval None
  */
static void USART_Config(void)
{ 
	USART_InitTypeDef	USART_InitStructure;
	NVIC_InitTypeDef	NVIC_InitStructure;
	GPIO_InitTypeDef	GPIO_InitStructure;
	
	RCC_APB2PeriphClockCmd(RCC_APB2Periph_USART1, ENABLE);
	
	/* GPIOA Configuration: Channel 1 and Channel 1N as alternate function push-pull */
	GPIO_InitStructure.GPIO_Pin = GPIO_Pin_9|GPIO_Pin_10;
	GPIO_InitStructure.GPIO_Mode = GPIO_Mode_AF;
	GPIO_InitStructure.GPIO_Speed = GPIO_Speed_50MHz;
	GPIO_InitStructure.GPIO_PuPd = GPIO_PuPd_UP;
	GPIO_Init(GPIOA, &GPIO_InitStructure);

	GPIO_PinAFConfig(GPIOA, GPIO_PinSource9, GPIO_AF_1);
	GPIO_PinAFConfig(GPIOA, GPIO_PinSource10, GPIO_AF_1);
	
	/* USARTx configured as follow:
	- BaudRate = 115200 baud  
	- Word Length = 8 Bits
	- Stop Bit = 1 Stop Bit
	- Parity = No Parity
	- Hardware flow control disabled (RTS and CTS signals)
	- Receive and transmit enabled
	*/
	USART_InitStructure.USART_BaudRate = 115200;
	USART_InitStructure.USART_WordLength = USART_WordLength_8b;
	USART_InitStructure.USART_StopBits = USART_StopBits_1;
	USART_InitStructure.USART_Parity = USART_Parity_No;
	USART_InitStructure.USART_HardwareFlowControl = USART_HardwareFlowControl_None;
	USART_InitStructure.USART_Mode = USART_Mode_Rx | USART_Mode_Tx;

	/* Enable the USART Interrupt */
	NVIC_InitStructure.NVIC_IRQChannel = USART1_IRQn;
	NVIC_InitStructure.NVIC_IRQChannelPriority = 3;
	NVIC_InitStructure.NVIC_IRQChannelCmd = ENABLE;
	NVIC_Init(&NVIC_InitStructure);
	
	USART_Init(USART1, &USART_InitStructure);
	
	USART_ITConfig(USART1, USART_IT_RXNE, ENABLE);
	USART_Cmd(USART1, ENABLE);
}
#endif

#ifdef  USE_FULL_ASSERT

/**
  * @brief  Reports the name of the source file and the source line number
  *         where the assert_param error has occurred.
  * @param  file: pointer to the source file name
  * @param  line: assert_param error line source number
  * @retval None
  */
void assert_failed(uint8_t* file, uint32_t line)
{ 
  /* User can add his own implementation to report the file name and line number,
     ex: printf("Wrong parameters value: file %s on line %d\r\n", file, line) */

  /* Infinite loop */
  while (1)
  {
  }
}
#endif

/**
  * @}
  */

/**
  * @}
  */

/************************ (C) COPYRIGHT STMicroelectronics *****END OF FILE****/
