IngramSwift/Buck-Controler-based-on-STM32/同步整流BUCK资料_V1.2/程序代码/Buck_M0+_V1.1/Utilities/inc/fuzzy_pid.h

#ifndef __FUZZY_PID_H
#define __FUZZY_PID_H

#include "stm32f0xx.h"

void FuzzySubjection(float f_e, float f_ec);
float FuzzyPID_KpCalc(float f_e, float f_ec);
float FuzzyPID_KiCalc(float f_e, float f_ec);
void FuzzyPID_Calc(float f_e, float f_ec, float* kp, float* ki);

#endif
