IngramSwift/Buck-Controler-based-on-STM32/同步整流BUCK资料_V1.2/程序代码/Buck_M0+_V1.1/Utilities/inc/calibration.h

#ifndef __CALIBRATION_H
#define __CALIBRATION_H

#include "stm32f0xx.h"   

#define FLASH_USER_START_ADDR   ((uint32_t)0x08006400)
#define CALIBRATION_V			15.00001f	//V
#define CALIBRATION_I			2.00001f	//A

typedef struct  
{
	float viRatio;
	float voRatio;
	float ioZero;
	float ioRatio;
}_uCalibration_Type;
extern _uCalibration_Type	calib;


void Read_CalibData(void);
void Save_CalibData(void);
void CalibrationOutput(void);


#endif
