IngramSwift/Buck-Controler-based-on-STM32/同步整流BUCK资料_V1.2/程序代码/Buck_M0+_V1.1/Utilities/inc/led.h

#ifndef __LED_H
#define __LED_H
#include "stm32f0xx.h"   


#define LED_OUT_ON		GPIOB->BRR = GPIO_Pin_1
#define LED_OUT_OFF		GPIOB->BSRR = GPIO_Pin_1
#define LED_OUT_TOGGLE	GPIOB->ODR^=GPIO_Pin_1

#define LED_CC_ON		GPIOB->BRR = GPIO_Pin_5;GPIOB->BSRR = GPIO_Pin_4
#define LED_CV_ON		GPIOB->BRR = GPIO_Pin_4;GPIOB->BSRR = GPIO_Pin_5
#define LED_CV_CC_OFF	GPIOB->BSRR = GPIO_Pin_4;GPIOB->BSRR = GPIO_Pin_5


void LED_Config(void);

#endif
