IngramSwift/Buck-Controler-based-on-STM32/同步整流BUCK资料_V1.2/程序代码/Buck_M0+_V1.1/Utilities/inc/myiic.h

#ifndef __MYIIC_H
#define __MYIIC_H
#include "stm32f0xx.h" 
#include "stdbool.h"

void iicDevStart(void);	
void iicDevStop(void);
void iicDevAck(void);
void iicDevNAck(void);
uint8_t iicDevWaitAck(void);
void iicDevSendByte(uint8_t txd);
uint8_t iicDevReceiveByte(uint8_t ack);

void myIIC_Config(void);

#endif
