IngramSwift/Buck-Controler-based-on-STM32/同步整流BUCK资料_V1.2/程序代码/Buck_M0+_V1.1/Utilities/inc/upload.h

#ifndef __UPLOAD_H
#define __UPLOAD_H

#if USE_USART_PRINTF

#include "stm32f0xx.h"   


typedef struct  
{
	int16_t iBuckOffset;
	int16_t iBoostOffset;
}_CalibMsgType;


extern _CalibMsgType 	CalibMsg;

uint8_t My_Comma_Pos(uint8_t *buf, uint8_t cx);
int My_Str2num(uint8_t *buf, uint8_t*dx);
void Calib_Analysis(_CalibMsgType *msg, uint8_t *buf);

#endif

#endif
