IngramSwift/Buck-Controler-based-on-STM32/同步整流BUCK资料_V1.2/程序代码/Buck_M0+_V1.1/Utilities/src/delay.c

#include "delay.h" 


void delay_us(uint32_t nus)
{		
	uint32_t ticks;
	uint32_t told,tnow,tcnt=0;
	uint32_t reload=SysTick->LOAD;	 	 
	ticks=nus*48; 			
	told=SysTick->VAL;       
	while(1)
	{
		tnow=SysTick->VAL;	
		if(tnow!=told)
		{	    
			if(tnow<told)tcnt+=told-tnow;
			else tcnt+=reload-tnow+told;	    
			told=tnow;
			if(tcnt>=ticks)break;
		}  
	};											    
}
